VitorMendesC/Giga-Teste-Fontes/images/on.png

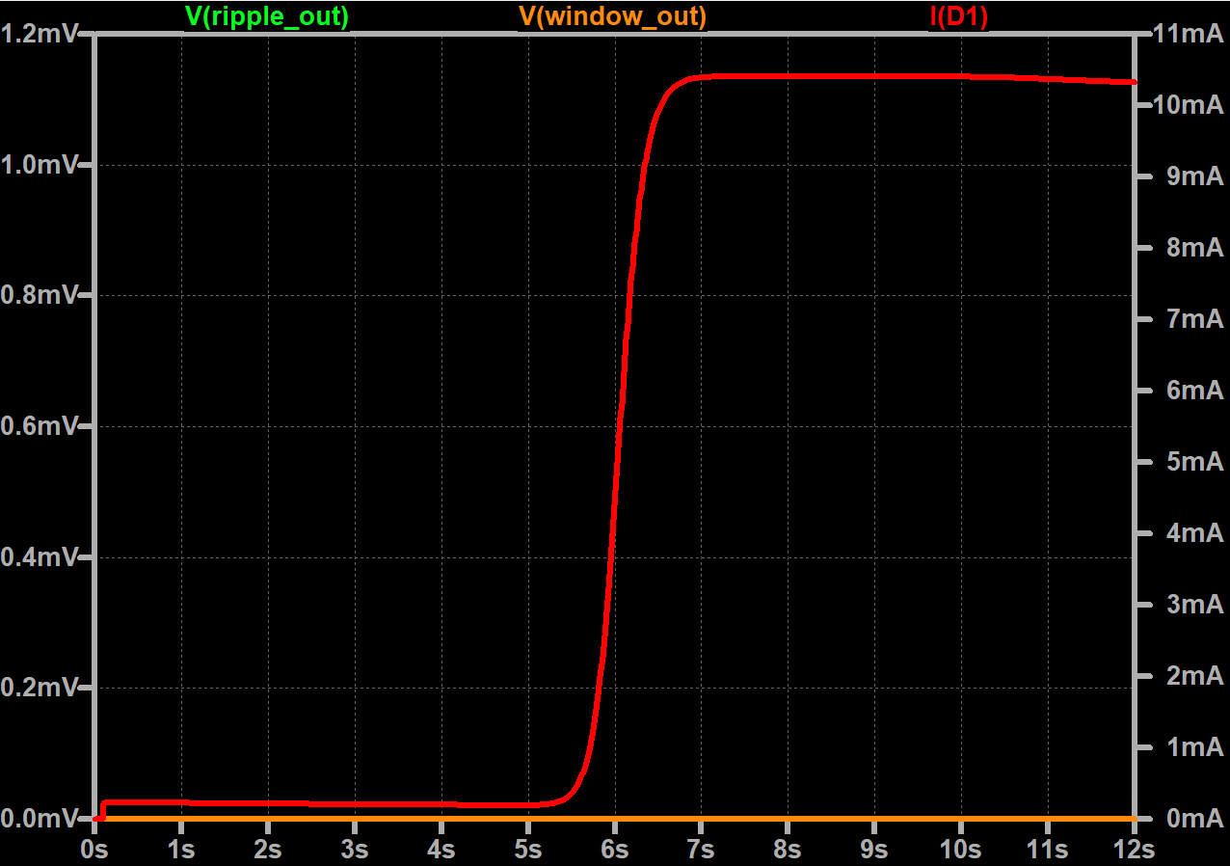
images/on.png
