VitorMendesC/Giga-Teste-Fontes/LTSpice files/carga.asc

C1: cap; 470µ
M1: nmos; Si7386DP
R1: res; 27.4k
RL1: res; 50k
S1: sw
S2: sw
V1: voltage; 5V
V2: voltage; SINE(0 0.25 60)
V3: voltage; 12V
V4: voltage; PULSE(0 5 100m 0.0001 0.0001 10)
Named nets: IN, G, 0, VCC, RESET, Vc1, START
Fonte
Teste
tau = 12.84
2.5 V em 3 segundos
.tran 12
.model SW SW(Ron=1 Roff=100Meg Vt=.7)
.ic V(Vc1)=0
