VitorMendesC/Giga-Teste-Fontes/LTSpice files/Janela.asc

C1: cap; 2.2µ
C2: cap; 10µ
C3: cap; 10µ
C4: cap; 10µ
C5: cap; 10µ
D1: diode
D2: LED
M1: nmos; Si7386DP
R1: res; 20k
R2: res; 1.49k
R3: res; 14.3k
R4: res; 12k
R5: res; 182k
R6: res; 10k
R7: res; 1k
R8: res; 28
S1: sw
U1: TLV1701
U2: TLV1701
U3: LTC6244
U4: LTC6244
V1: voltage; 5V
V2: voltage; SINE(0 0.03 20k)
V3: voltage; 12V
V4: voltage; 12V
V5: voltage; PULSE(0 -0.4 20m 0.001 0.001 3)
V6: voltage; PULSE(0 5 1m 0.0001 0.0001 10)
Named nets: 0, G, VCC, VEE, IN, WINDOW_OUT, START, Vt1, Vt2
Fonte
Teste
.tran 40m
.model SW SW(Ron=.1 Roff=100Meg Vt=.7 vh =.1)
.ic V(Vc1)=0
