VitorMendesC/Giga-Teste-Fontes/LTSpice files/led_logic.asc

C1: cap; 470µ
D1: LED
M1: nmos; Si7386DP
M2: nmos; Si7386DP
M3: nmos; Si7386DP
M4: nmos; Si7386DP
M5: nmos; Si7386DP
R1: res; 10k
R2: res; 10k
R3: res; 850
R4: res; 48.7k
S1: sw
S2: sw
V1: voltage; 12V
V2: voltage; PULSE(0 5 100m 0.0001 0.0001 10)
V3: voltage; PULSE(0 0 3 0.001 0.001 10)
V4: voltage; PULSE(0 0 3 0.001 0.001 20)
Named nets: WINDOW_OUT, RIPPLE_OUT, VCC, 0, Vc1, START, RESET, G
tau = 22.68
2.5 V em 6 segundos
.tran 12
.model SW SW(Ron=1 Roff=100Meg Vt=.7)
.ic V(Vc1)=0
