VitorMendesC/Giga-Teste-Fontes/LTSpice files/ProjII.asc

C1: cap; 2.2µ
C2: cap; 2.2µ
C3: cap; 10µ
C4: cap; 470µ
C5: cap; 10µ
C6: cap; 10µ
C7: cap; 10µ
C8: cap; 10µ
C9: cap; 10µ
C10: cap; 10µ
C11: cap; 10µ
C12: cap; 470µ
D1: diode
D2: diode
D3: LED
D4: LED
D5: LED
M1: nmos; Si7386DP
M2: nmos; Si7386DP
M3: nmos; Si7386DP
M4: nmos; Si7386DP
M5: nmos; Si7386DP
M6: nmos; Si7386DP
M7: nmos; Si7386DP
R1: res; 20k
R2: res; 1.49k
R3: res; 14.3k
R4: res; 12k
R5: res; 182k
R6: res; 182k
R7: res; 500
R8: res; 590k
R9: res; 1k
R10: res; 1k
R11: res; 10k
R12: res; 1k
R13: res; 27.4k
R14: res; 10k
R15: res; 10k
R16: res; 850
R17: res; 28
R18: res; 48.7k
R19: res; 9k
RL: res; 50k
S1: sw
S2: sw
S3: sw
S4: sw
S5: sw
U1: TLV1701
U2: TLV1701
U3: LTC6244
U4: LTC6244
U5: LTC6244
U6: LTC6244
U7: LTC6244
V1: voltage; 5V
V2: voltage; SINE(0 0.03 20k)
V3: voltage; 12V
V4: voltage; PULSE(0 -0.4 20m 0.001 0.001 3)
V5: voltage; PULSE(0 5 100m 0.0001 0.0001 10)
Named nets: 0, G, VCC, IN, RESET, START, Vc1, WINDOW_OUT, Vt1, Vt2, RIPPLE_OUT, Vrmax, V+
.tran 100m
TO DO:
- Valores comerciais nos componentes;
- Capacitores de desacoplamento;
.model SW SW(Ron=1 Roff=100Meg Vt=.7)
.ic V(Vc1)=0
Fonte
Teste
tau = 12.84
2.5 V em 3 segundos
tau = 22.68
2.5 V em 6 segundos
