VitorMendesC/Giga-Teste-Fontes/LTSpice files/ripple.asc

C1: cap; 2.2µ
C2: cap; 10µ
C3: cap; 10µ
C4: cap; 10µ
C5: cap; 10µ
D1: diode
D2: LED
R1: res; 182k
R2: res; 500
R3: res; 590k
R4: res; 1k
R5: res; 1k
R6: res; 9k
U1: LTC6244
U2: LTC6244
U3: LTC6244
V1: voltage; 5V
V2: voltage; SINE(0 0.009 60)
V3: voltage; 12V
V4: voltage; 12V
V5: voltage; SINE(0 0.010 60 50m)
Named nets: 0, G, VCC, VEE, IN, RIPPLE_OUT, Vrmax, V+
Fonte
Teste
.tran 100m
