VitorMendesC/Giga-Teste-Fontes/(list of files, drawings)

Other design files:
LTSpice files/Modelos PSPICE/sbom859c/tlv1701.dsn
LTSpice files/Modelos PSPICE/sbom859c/tlv1701.opj
